zzdhybthu/MIPS32-CPU-Pipeline/report/asserts/critical_path_schematic.pdf

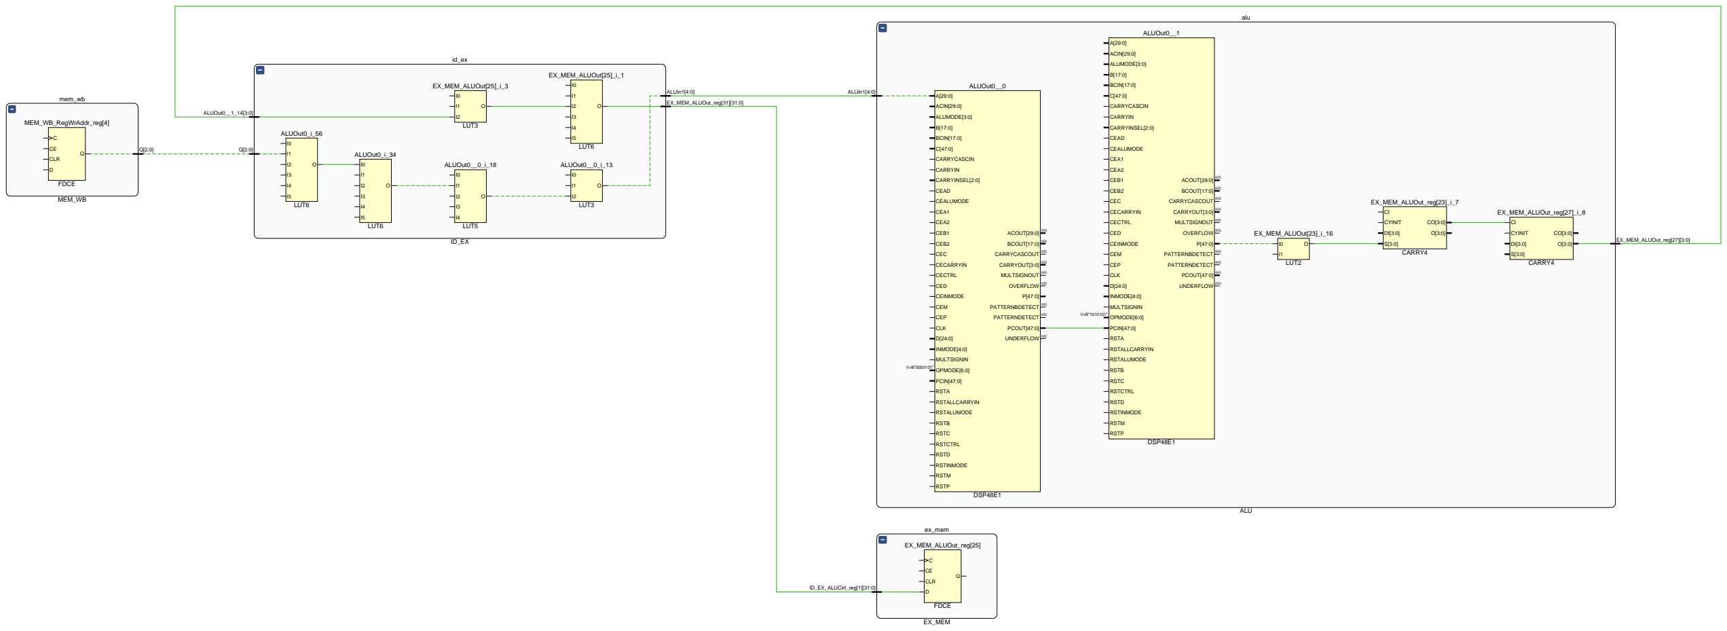
[picture p20: figure]
alu; ALU; ALUIn1[4:0]; EX_MEM_ALUOut_reg[27][3:0]; ex_mem; EX_MEM; ID_EX_ALUCtrl_reg[1][31:0]; mem_wb; MEM_WB; ALUOut0__1_14[3:0]; EX_MEM_ALUOut_reg[31][31:0]; EX_MEM_ALUOut_reg[23]_i_7; CARRY4; CI CYINIT; EX_MEM_ALUOut_reg[27]_i_8; EX_MEM_ALUOut[25]_i_3; LUT3; EX_MEM_ALUOut_reg[25]; FDCE; CECLR; EX_MEM_ALUOut[25]_i_1; LUT6; ALUOut0__0_i_13; ALUOut0__0_i_18; LUT5; ALUOut0_i_34; ALUOut0_i_56; EX_MEM_ALUOut[23]_i_16; LUT2; ALUOut0__1; DSP48E1; CARRYCASCOUT n/c; MULTSIGNOUT n/c OVERFLOW n/c; PATTERNBDETECT n/c PATTERNDETECT n/c; UNDERFLOW n/c; CARRYCASCIN; CARRYIN; CEA1 CEA2; CEAD; CEALUMODE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
