zzdhybthu/MIPS32-CPU-Pipeline/report/asserts/critical_path_summary.png

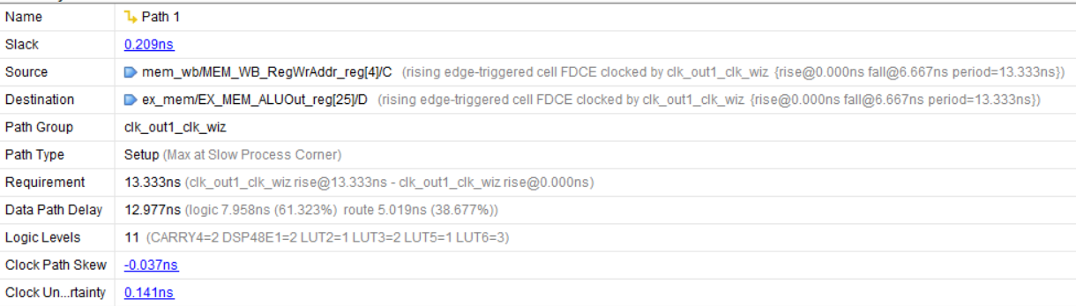
report/asserts/critical_path_summary.png
