zzdhybthu/MIPS32-CPU-Pipeline/report/asserts/pipeline_design.png

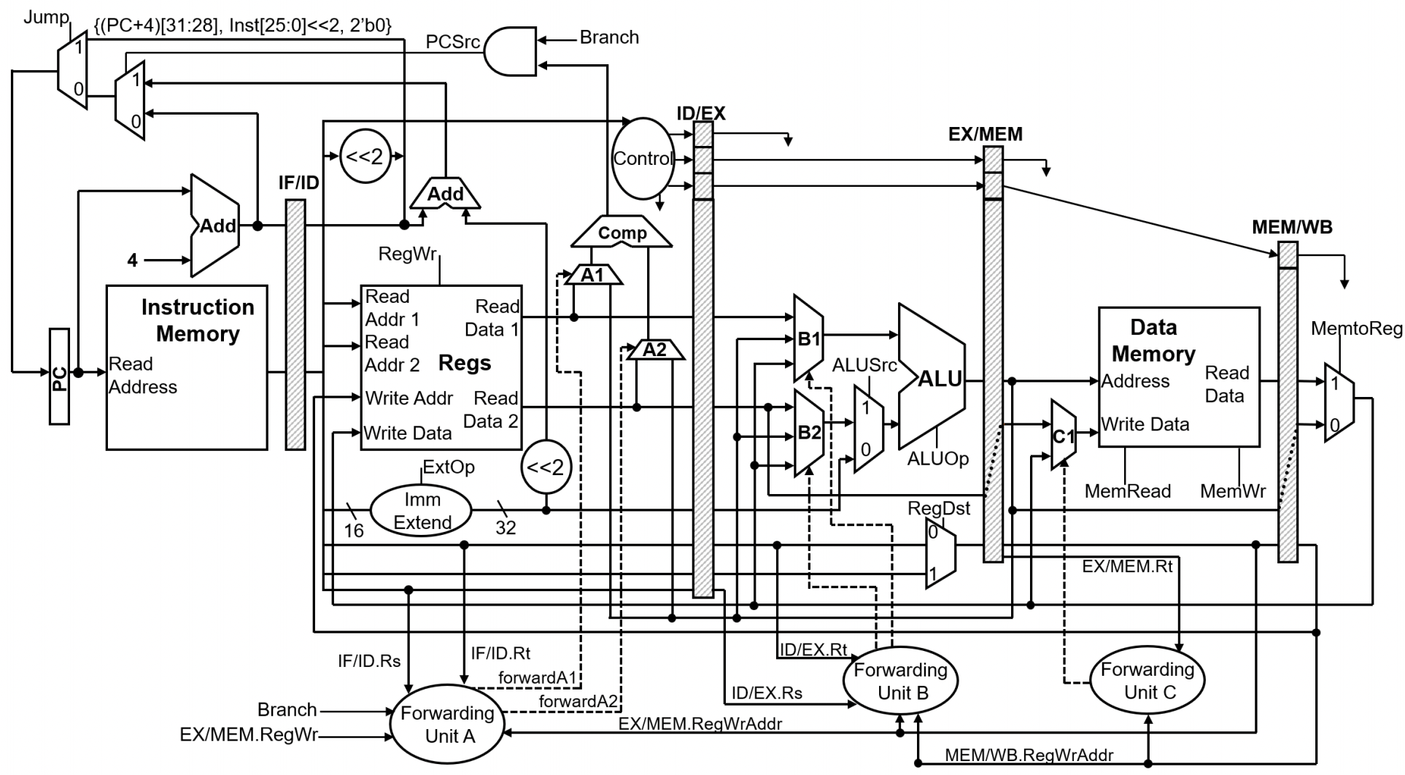
report/asserts/pipeline_design.png
