zzdhybthu/MIPS32-CPU-Pipeline/(commit log)

2024-07-02 fix: fix known bugs
    [ALU.v, ALU_Ctrl.v, Branch.v, CPU.v, Ctrl.v, Data_Mem.v, EX_MEM.v, Forward.v]
2024-07-02 feat: add insert sort test source
2024-07-02 fix: fix known bugs, pass 3 main tests
    [CPU.v, PC.v]
2024-07-03 fix: add j loop on program ending
    [binary_insert_sort.asm]
2024-07-03 feat: add led display
2024-07-05 fix: pass led test
    [CPU.v, CPU.xdc, Data_Mem.v, ID_EX.v, IF_ID.v, PC.v]
2024-07-05 feat: add uart hardware
2024-07-05 feat: add uart instruction
2024-07-05 test: add test for uart
2024-07-06 milestone: 🤗pass all tests for sort method, led display and uart transition
2024-07-07 milestone: 🤗 finsh report
